Mee42/cube/motor_controller/motor_controller.kicad_pcb

## KiCad design motor_controller/motor_controller.kicad_pcb (2026-05-20)

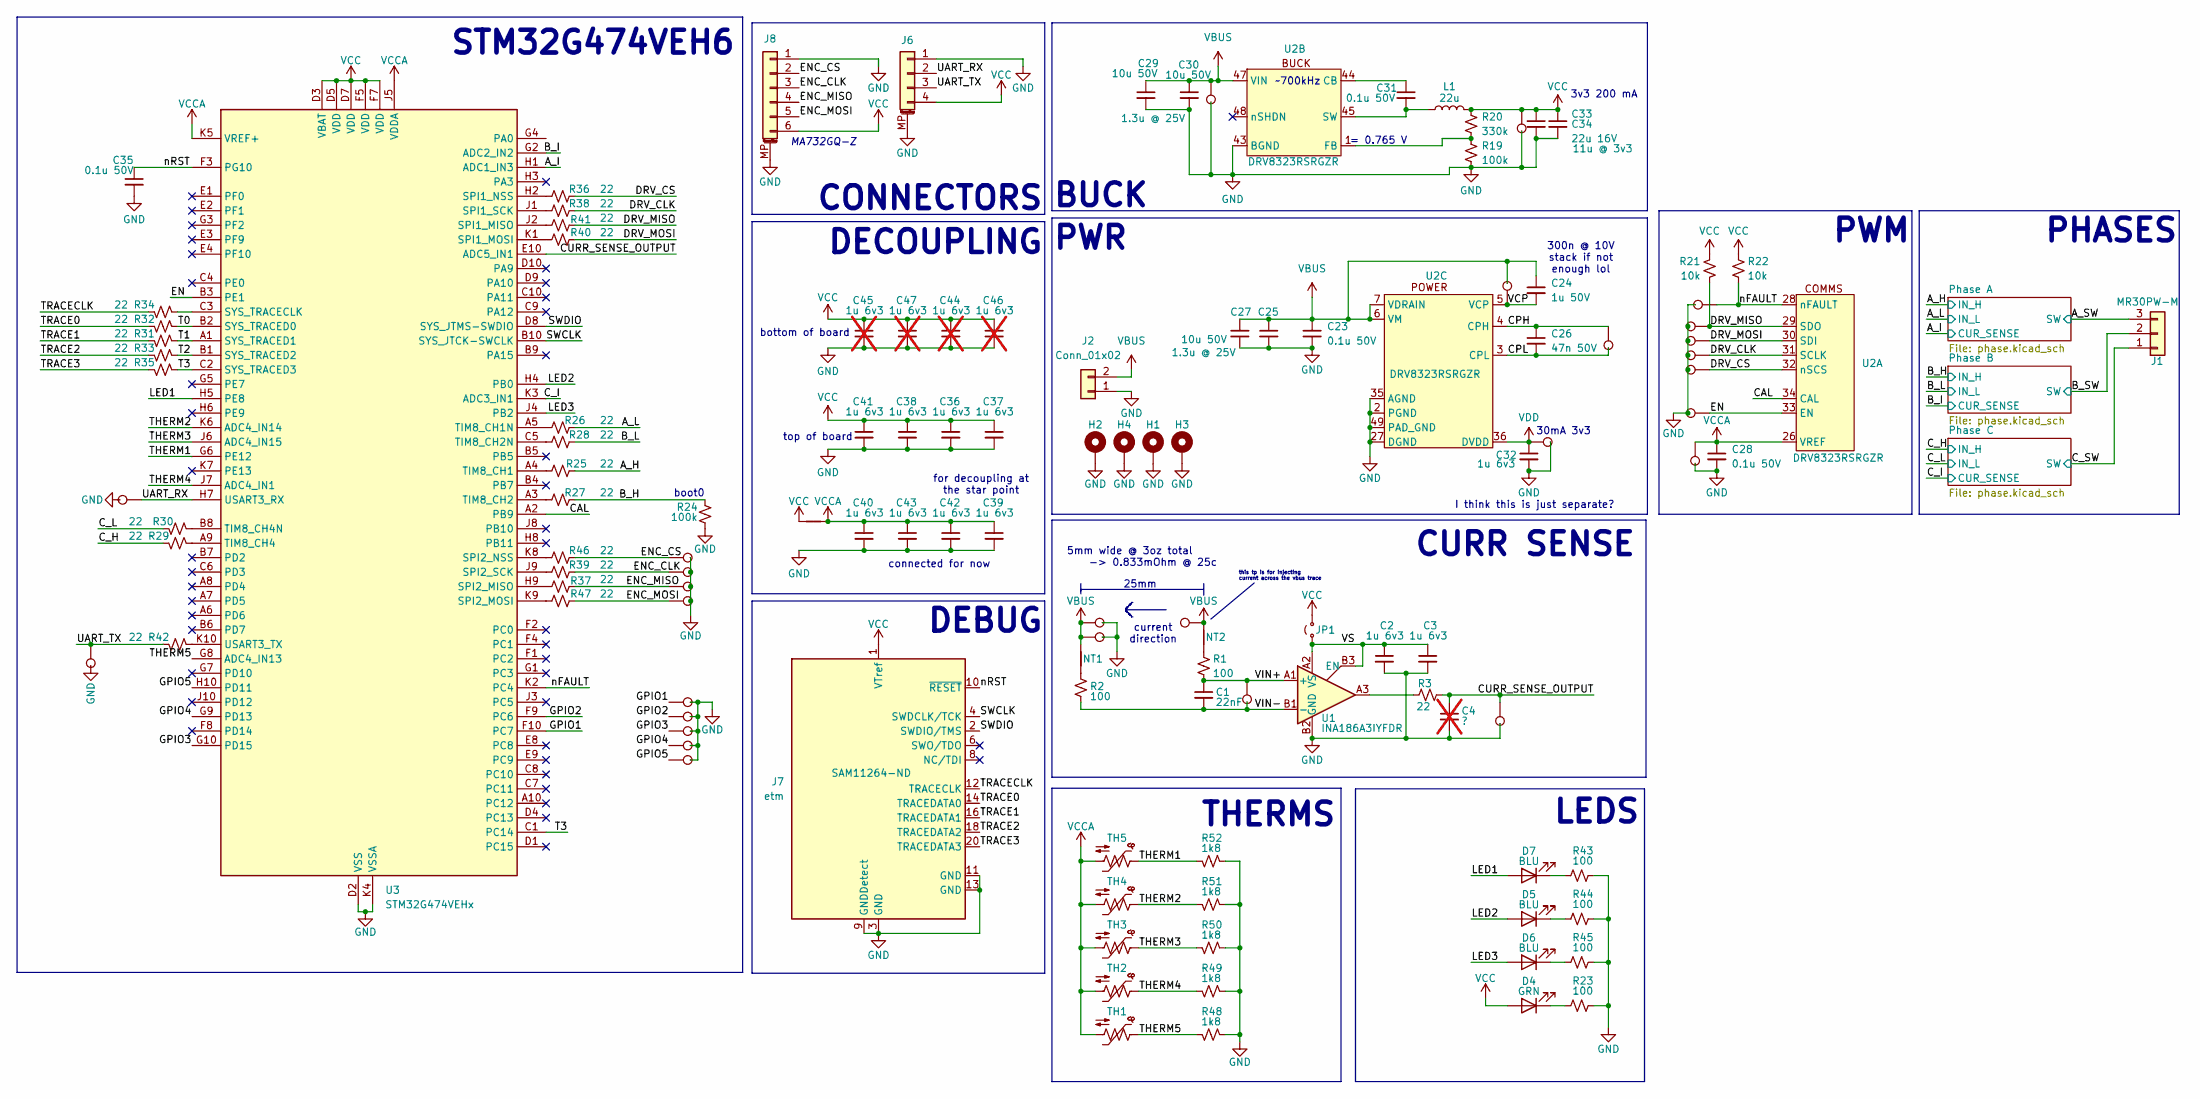
[picture p1: schematic motor_controller.kicad_sch]

Parts:
C1: 22nF; C_0402_1005Metric; MPN CC0402KRX7R9BB223
C2, C3, C32, C36, C37, C38, C39, C40, C41, C42, C43: 1u 6v3; C_0402_1005Metric; MPN CL05A105KQ5NNNC
C4: ?; C_0402_1005Metric; not fitted
C23, C28, C31, C35: 0.1u 50V; C_0402_1005Metric; MPN CL05B104KB54PNC
C24: 1u 50V; C_0603_1608Metric; MPN CL10A105KB8NNNC
C25, C27, C29, C30: 10u 50V; C_0805_2012Metric; MPN CL21A106KBYQNNE
C26: 47n 50V; C_0402_1005Metric; MPN CL05B473KB5VPNC
C33, C34: 22u 16V; C_0603_1608Metric; rating 11u @ 3v3; MPN CL10A226MO7JZNC
C44, C45, C46, C47: 1u 6v3; C_0402_1005Metric; MPN CL05B105KQ5NQNC; not fitted
D4: GRN; LED_0402_1005Metric; MPN XL-1005UGC
D5, D6, D7: BLU; LED_0402_1005Metric; MPN XL-1005UBC
H1, H2, H3, H4: MountingHole_Pad; MountingHole_2.2mm_M2_DIN965_Pad
J1: Conn_01x03; AMASS_MR30PW-M_1x03_P3.50mm_Horizontal; MPN MR30PW-M
J2: Conn_01x02; AMASS_XT30U-M_1x02_P5.0mm_Vertical
J6: uart; JST_ZE_SM04B-ZESS-TB_1x04-1MP_P1.50mm_Horizontal; MPN SM04B-ZESS-TB
J7: etm; SAMTEC_FTSH-110-01-F-DV-007; MPN FTSH-110-01-F-DV-007-K
J8: encoder; JST_ZE_SM06B-ZESS-TB_1x06-1MP_P1.50mm_Horizontal; MPN SM06B-ZESS-TB
JP1: Jumper_2_Bridged; SolderJumper-2_P1.3mm_Open_TrianglePad1.0x1.5mm
L1: 22u; L_0603_1608Metric; MPN CWF1610A-220K
NT1, NT2, NT3: NetTie_2; NetTie-2_SMD_Pad0.5mm
R1, R2, R23, R43, R44, R45: 100; R_0402_1005Metric; MPN FRC0402J101 TS
R3, R25, R26, R27, R28, R29, R30, R31, R32, R33, R34, R35, R36, R37, R38, R39, R40, R41, R42, R46, R47: 22; R_0402_1005Metric; MPN FRC0402J220 TS
R19, R24: 100k; R_0402_1005Metric; MPN FRC0402J104 TS
R20: 330k; R_0402_1005Metric; MPN FRC0402J334 TS
R21, R22: 10k; R_0402_1005Metric; MPN FRC0402J103 TS
R48, R49, R50, R51, R52: 1k8; R_0402_1005Metric; MPN FRC0402F1801TS
TH1, TH2, TH3, TH4, TH5: Thermistor_NTC_US; test point d1.5; MPN NRMR104F3435B2F
TP1, TP3, TP4, TP14, TP15, TP16, TP17, TP18, TP19, TP20, TP21, TP22, TP23, TP24, TP25, TP26, TP31, TP37, TP38, TP39, TP40, TP41, TP42, TP43, TP44, TP45, TP46: test point; test point d1.5
TP2: TestPoint; PinHeader_1x01_P2.54mm_Vertical
U1: INA186A3IYFDR; TSBGA_0.4mm_flipped; MPN INA186A3IYFDR
U2: VQFN-48-1EP_7x7mm_P0.5mm_EP4.1x4.1mm_ThermalVias; MPN DRV8323RSRGZR
U3: STM32G474VEHx; TFBGA-100_8x8mm_Layout10x10_P0.8mm; MPN STM32G474VEH6

Connections:
/A_H: R25.2; also elsewhere on the board
/A_I: U3.H1 (ADC1_IN3); also elsewhere on the board
/A_L: R26.2; also elsewhere on the board
/A_SW: J1.3; also elsewhere on the board
/B_H: R24.1, R27.2, U2.39 (INHB); also elsewhere on the board
/B_I: U2.24 (SOB), U3.G2 (ADC2_IN2); also elsewhere on the board
/B_L: R28.2, U2.40 (INLB); also elsewhere on the board
/B_SW: J1.2, U2.16 (SHB); also elsewhere on the board
/CAL: U2.34 (CAL), U3.A2 (PB9)
/CPH: C26.1, TP19.1, U2.4 (CPH)
/CPL: C26.2, TP19.2 (1), U2.3 (CPL)
/CURR_SENSE_OUTPUT: C4.1, R3.2, TP4.1, U3.E10 (ADC5_IN1)
/C_H: R29.2, U2.41 (INHC); also elsewhere on the board
/C_I: U2.23 (SOC), U3.K3 (ADC3_IN1); also elsewhere on the board
/C_L: R30.2, U2.42 (INLC); also elsewhere on the board
/C_SW: J1.1, U2.19 (SHC); also elsewhere on the board
/DRV_CLK: R38.2, TP18.1, U2.31 (SCLK)
/DRV_CS: R36.2, TP15.1, U2.32 (nSCS)
/DRV_MISO: R21.1, R41.2, TP21.1, U2.29 (SDO)
/DRV_MOSI: R40.2, TP20.1, U2.30 (SDI)
/EN: TP14.1, U2.33 (EN), U3.B3 (PE1)
/ENC_CLK: J8.3, R39.2, TP42.1
/ENC_CS: J8.2, R46.2, TP44.1
/ENC_MISO: J8.4, R37.2, TP40.1
/ENC_MOSI: J8.5, R47.2, TP38.1
/GPIO1: TP37.1, U3.F10 (PC7)
/GPIO2: TP39.1, U3.F9 (PC6)
/GPIO3: TP41.1, U3.G10 (PD15)
/GPIO4: TP43.1, U3.G9 (PD13)
/GPIO5: TP45.1, U3.H10 (PD11)
/LED1: D7.2 (A), U3.H5 (PE8)
/LED2: D5.2 (A), U3.H4 (PB0)
/LED3: D6.2 (A), U3.J4 (PB2)
/SWCLK: J7.4 (SWDCLK/TCK), U3.B10 (SYS_JTCK-SWCLK)
/SWDIO: J7.2 (SWDIO/TMS), U3.D8 (SYS_JTMS-SWDIO)
/T0: R32.1, U3.B2 (SYS_TRACED0)
/T1: R31.1, U3.A1 (SYS_TRACED1)
/T2: R33.1, U3.B1 (SYS_TRACED2)
/T3: R35.1, U3.C1 (PC14), U3.C2 (SYS_TRACED3)
/THERM1: R52.1, TH5.1, U3.G6 (PE12)
/THERM2: R51.1, TH4.1, U3.K6 (ADC4_IN14)
/THERM3: R50.1, TH3.1, U3.J6 (ADC4_IN15)
/THERM4: R49.1, TH2.1, U3.J7 (ADC4_IN1)
/THERM5: R48.1, TH1.1, U3.G8 (ADC4_IN13)
/TRACE0: J7.14 (TRACEDATA0), R32.2
/TRACE1: J7.16 (TRACEDATA1), R31.2
/TRACE2: J7.18 (TRACEDATA2), R33.2
/TRACE3: J7.20 (TRACEDATA3), R35.2
/TRACECLK: J7.12 (TRACECLK), R34.2
/UART_RX: J6.2, TP31.1, U3.H7 (USART3_RX)
/UART_TX: J6.3, R42.2, TP25.1
/VCP: C24.2, TP16.1, U2.5 (VCP)
/VIN+: C1.1, R1.2, TP3.1, U1.A1 (+)
/VIN-: C1.2, R2.2, TP3.2 (1), U1.B1 (-)
/VS: C2.1, C3.1, JP1.1 (A), U1.A2 (VS), U1.B3 (EN)
/nFAULT: R22.1, TP23.1, U2.28 (nFAULT), U3.K2 (PC4)
/nRST: C35.1, J7.10 (~RESET), U3.F3 (PG10)
GND: C2.2, C3.2, C4.2, C23.2, C25.2, C27.2, C28.2, C29.2, C30.2, C32.2, C33.2, C34.2, C35.2, C36.2, C37.2, C38.2, C39.2, C40.2, C41.2, C42.2, C43.2, C44.2, C45.2, C46.2, C47.2, H1.1 (1_1), H2.1 (1_1), H3.1 (1_1), H4.1 (1_1), J2.1, J6.1, J6.MP (MountPin), J7.3 (GND), J7.5 (GND), J7.9 (GNDDetect), J7.11 (GND), J7.13 (GND), J7.15 (GND), J7.17 (GND), J7.19 (GND), J8.1, J8.MP (MountPin), R19.2, R23.2, R24.2, R43.2, R44.2, R45.2, R48.2, R49.2, R50.2, R51.2, R52.2, TP1.2 (1), TP4.2 (1), TP14.2 (1), TP15.2 (1), TP17.2 (1), TP18.2 (1), TP20.2 (1), TP21.2 (1), TP22.2 (1), TP23.2 (1), TP24.2 (1), TP25.2 (1), TP26.2 (1), TP31.2 (1), TP37.2 (1), TP38.2 (1), TP39.2 (1), TP40.2 (1), TP41.2 (1), TP42.2 (1), TP43.2 (1), TP44.2 (1), TP45.2 (1), TP46.2 (1), U1.B2 (GND), U2.2 (PGND), U2.27 (DGND), U2.35 (AGND), U2.43 (BGND), U2.49 (PAD_GND), U3.D2 (VSS), U3.D6 (VSS), U3.E5 (VSS), U3.E6 (VSS), U3.E7 (VSS), U3.F6 (VSS), U3.K4 (VSSA); also elsewhere on the board
unnamed: D4.1 (K), R23.1
unnamed: D5.1 (K), R44.1
unnamed: D6.1 (K), R45.1
unnamed: D7.1 (K), R43.1
unnamed: NT1.1, R2.1
unnamed: NT2.1, R1.1
unnamed: R3.1, U1.A3
unnamed: C31.1, U2.44 (CB)
unnamed: R19.1, R20.2, U2.1 (FB)
unnamed: C31.2, L1.1, U2.45 (SW)
unnamed 87: U2.17 (GHB); also elsewhere on the board
unnamed 88: U2.15 (GLB); also elsewhere on the board
unnamed 89: U2.13 (SNB); also elsewhere on the board
unnamed 90: U2.14 (SPB); also elsewhere on the board
unnamed 91: U2.18 (GHC); also elsewhere on the board
unnamed 92: U2.20 (GLC); also elsewhere on the board
unnamed 93: U2.22 (SNC); also elsewhere on the board
unnamed 94: U2.21 (SPC); also elsewhere on the board
unnamed: R36.1, U3.H2 (SPI1_NSS)
unnamed: R38.1, U3.J1 (SPI1_SCK)
unnamed: R41.1, U3.J2 (SPI1_MISO)
unnamed: R40.1, U3.K1 (SPI1_MOSI)
unnamed: R26.1, U3.A5 (TIM8_CH1N)
unnamed: R28.1, U3.C5 (TIM8_CH2N)
unnamed: R25.1, U3.A4 (TIM8_CH1)
unnamed: R27.1, U3.A3 (TIM8_CH2)
unnamed: R46.1, U3.K8 (SPI2_NSS)
unnamed: R39.1, U3.J9 (SPI2_SCK)
unnamed: R37.1, U3.H9 (SPI2_MISO)
unnamed: R47.1, U3.K9 (SPI2_MOSI)
unnamed: R30.1, U3.B8 (TIM8_CH4N)
unnamed: R29.1, U3.A9 (TIM8_CH4)
unnamed: R42.1, U3.K10 (USART3_TX)
unnamed: R34.1, U3.C3 (SYS_TRACECLK)
VBUS: C23.1, C24.1, C25.1, C27.1, C29.1, C30.1, J2.2, NT1.2, NT2.2, TP1.1, TP2.1 (1_1), TP16.2 (1), TP17.1, TP46.1, U2.6 (VM), U2.7 (VDRAIN), U2.47 (VIN); also elsewhere on the board
VCC: C33.1, C34.1, C36.1, C37.1, C38.1, C41.1, C44.1, C45.1, C46.1, C47.1, D4.2 (A), J6.4, J7.1 (VTref), J8.6, JP1.2 (B), L1.2, NT3.2, R20.1, R21.2, R22.2, TP22.1, U3.D3 (VBAT), U3.D5 (VDD), U3.D7 (VDD), U3.F5 (VDD), U3.F7 (VDD)
VCCA: C28.1, C39.1, C40.1, C42.1, C43.1, NT3.1, TH1.2, TH2.2, TH3.2, TH4.2, TH5.2, TP24.1, U2.26 (VREF), U3.J5 (VDDA), U3.K5 (VREF+)
VDD: C32.1, TP26.1, U2.36 (DVDD)

Notes on the sheet:
30mA 3v3
connected for now
25mm
LEDS
PWM
300n @ 10V stack if not enough lol
~700kHz
this tp is for injecting current across the vbus trace
BUCK
PHASES
current direction
I think this is just separate?
CURR SENSE
STM32G474VEH6
PWR
3v3 200 mA
5mm wide @ 3oz total -> 0.833mOhm @ 25c
top of board
boot0
MA732GQ-Z
bottom of board
DEBUG
CONNECTORS
DECOUPLING
for decoupling at the star point
THERMS
= 0.765 V

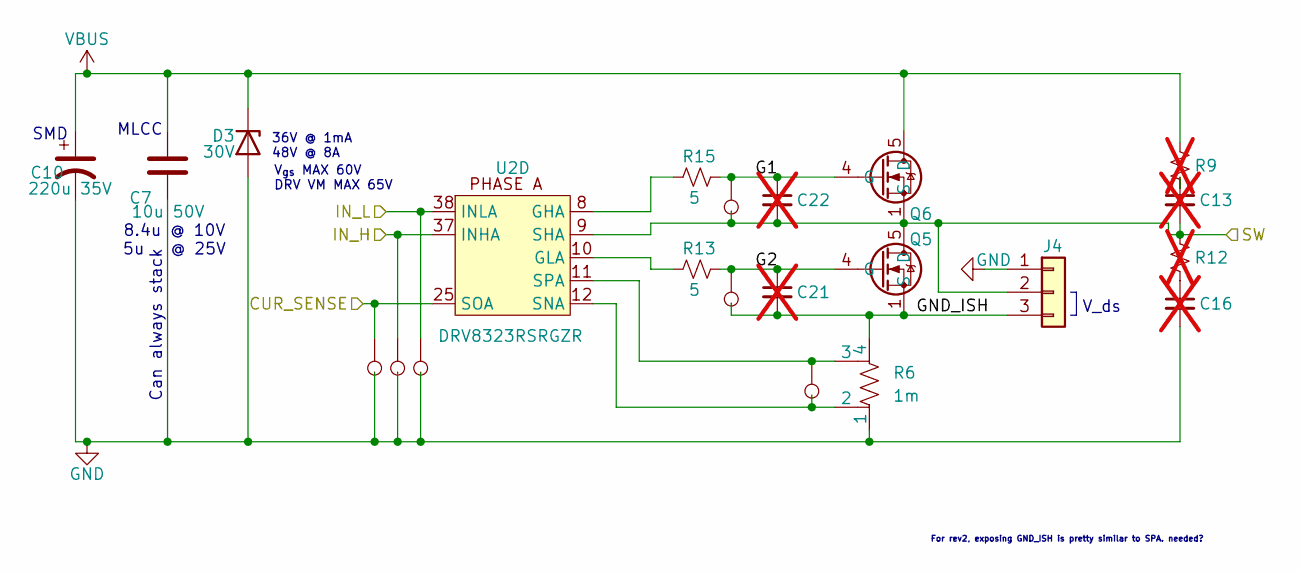
[picture p2: schematic phase.kicad_sch]

Parts:
C7: 10u 50V; C_1210_3225Metric; MPN CL32Y106KBJVPJE
C10: 220u 35V; CP_Elec_6.3x7.7_mine; MPN RV35V220M6X8
C13, C16, C21, C22: C_Small; C_0402_1005Metric; not fitted
D3: 30V; D_SMA; MPN SMAJ30A
J4: Conn_01x03; tp_3x
Q5, Q6: Infineon_PG-TDSON-8_6.15x5.15mm; MPN BSC110N06NS3GATMA1
R6: 1m; R_0805_SHUNT; MPN PA0805FRL870R001L
R9, R12: R_Small_US; R_0402_1005Metric; not fitted
R13, R15: 5; R_0402_1005Metric; MPN FRC0402J3R3 TS
TP7, TP10, TP11, TP27, TP33, TP36: test point; test point d1.5
U2: VQFN-48-1EP_7x7mm_P0.5mm_EP4.1x4.1mm_ThermalVias; MPN DRV8323RSRGZR

Connections:
/A_H: TP33.1, U2.37 (INHA); also elsewhere on the board
/A_I: TP36.1, U2.25 (SOA); also elsewhere on the board
/A_L: TP27.1, U2.38 (INLA); also elsewhere on the board
/A_SW: C13.2, C22.2, J4.2, Q5.5 (D), Q6.1 (S), Q6.2 (S), Q6.3 (S), R12.1, TP11.2 (1), U2.9 (SHA); also elsewhere on the board
/B_H: U2.39 (INHB); also elsewhere on the board
/B_I: U2.24 (SOB); also elsewhere on the board
/B_L: U2.40 (INLB); also elsewhere on the board
/B_SW: U2.16 (SHB); also elsewhere on the board
/C_H: U2.41 (INHC); also elsewhere on the board
/C_I: U2.23 (SOC); also elsewhere on the board
/C_L: U2.42 (INLC); also elsewhere on the board
/C_SW: U2.19 (SHC); also elsewhere on the board
/Phase A/G1: C22.1, Q6.4 (G), R15.2, TP11.1
/Phase A/G2: C21.1, Q5.4 (G), R13.2, TP10.1
/Phase A/GND_ISH: C21.2, J4.3, Q5.1 (S), Q5.2 (S), Q5.3 (S), R6.4, TP10.2 (1)
GND: C7.2, C10.2, C16.2, D3.2 (A), J4.1, R6.1, TP27.2 (1), TP33.2 (1), TP36.2 (1); also elsewhere on the board
unnamed: C13.1, R9.2
unnamed: C16.1, R12.2
unnamed: R15.1, U2.8 (GHA)
unnamed: R13.1, U2.10 (GLA)
unnamed: R6.2, TP7.2 (1), U2.12 (SNA)
unnamed: R6.3, TP7.1, U2.11 (SPA)
unnamed 87: U2.17 (GHB); also elsewhere on the board
unnamed 88: U2.15 (GLB); also elsewhere on the board
unnamed 89: U2.13 (SNB); also elsewhere on the board
unnamed 90: U2.14 (SPB); also elsewhere on the board
unnamed 91: U2.18 (GHC); also elsewhere on the board
unnamed 92: U2.20 (GLC); also elsewhere on the board
unnamed 93: U2.22 (SNC); also elsewhere on the board
unnamed 94: U2.21 (SPC); also elsewhere on the board
VBUS: C7.1, C10.1, D3.1 (K), Q6.5 (D), R9.1; also elsewhere on the board

Parts of its further copies:
C5, C6: 10u 50V; C_1210_3225Metric; MPN CL32Y106KBJVPJE
C8, C9: 220u 35V; CP_Elec_6.3x7.7_mine; MPN RV35V220M6X8
C11, C12, C14, C15, C17, C18, C19, C20: C_Small; C_0402_1005Metric; not fitted
D1, D2: 30V; D_SMA; MPN SMAJ30A
J3, J5: Conn_01x03; tp_3x
R4, R5: 1m; R_0805_SHUNT; MPN PA0805FRL870R001L
R7, R8, R10, R11: R_Small_US; R_0402_1005Metric; not fitted
R14, R16, R17, R18: 5; R_0402_1005Metric; MPN FRC0402J3R3 TS
TP5, TP6, TP8, TP9, TP12, TP13, TP28, TP29, TP30, TP32, TP34, TP35: test point; test point d1.5

Connections of its further copies:
/B_H: TP34.1; also elsewhere on the board
/B_I: TP32.1; also elsewhere on the board
/B_L: TP28.1; also elsewhere on the board
/B_SW: C12.2, C19.2, J3.2, R11.1, TP8.2 (1); also elsewhere on the board
/C_H: TP35.1; also elsewhere on the board
/C_I: TP30.1; also elsewhere on the board
/C_L: TP29.1; also elsewhere on the board
/C_SW: C11.2, C18.2, J5.2, R10.1, TP13.2 (1); also elsewhere on the board
/Phase B/G1: C19.1, R16.2, TP8.1; also elsewhere on the board
/Phase B/G2: C20.1, R14.2, TP9.1; also elsewhere on the board
/Phase B/GND_ISH: C20.2, J3.3, R5.4, TP9.2 (1); also elsewhere on the board
/Phase C/G1: C18.1, R17.2, TP13.1; also elsewhere on the board
/Phase C/G2: C17.1, R18.2, TP12.1; also elsewhere on the board
/Phase C/GND_ISH: C17.2, J5.3, R4.4, TP12.2 (1); also elsewhere on the board
GND: C5.2, C6.2, C8.2, C9.2, C14.2, C15.2, D1.2 (A), D2.2 (A), J3.1, J5.1, R4.1, R5.1, TP28.2 (1), TP29.2 (1), TP30.2 (1), TP32.2 (1), TP34.2 (1), TP35.2 (1); also elsewhere on the board
unnamed: C11.1, R7.2
unnamed: C12.1, R8.2
unnamed: C14.1, R10.2
unnamed: C15.1, R11.2
unnamed 87: R16.1; also elsewhere on the board
unnamed 88: R14.1; also elsewhere on the board
unnamed 89: R5.2, TP6.2 (1); also elsewhere on the board
unnamed 90: R5.3, TP6.1; also elsewhere on the board
unnamed 91: R17.1; also elsewhere on the board
unnamed 92: R18.1; also elsewhere on the board
unnamed 93: R4.2, TP5.2 (1); also elsewhere on the board
unnamed 94: R4.3, TP5.1; also elsewhere on the board
VBUS: C5.1, C6.1, C8.1, C9.1, D1.1 (K), D2.1 (K), R7.1, R8.1; also elsewhere on the board

Notes on the sheet:
SMD
36V @ 1mA 48V @ 8A
V_{gs} MAX 60V DRV VM MAX 65V
Can always stack
MLCC
For rev2, exposing GND_ISH is pretty similar to SPA. needed?
8.4u @ 10V 5u @ 25V
V_ds

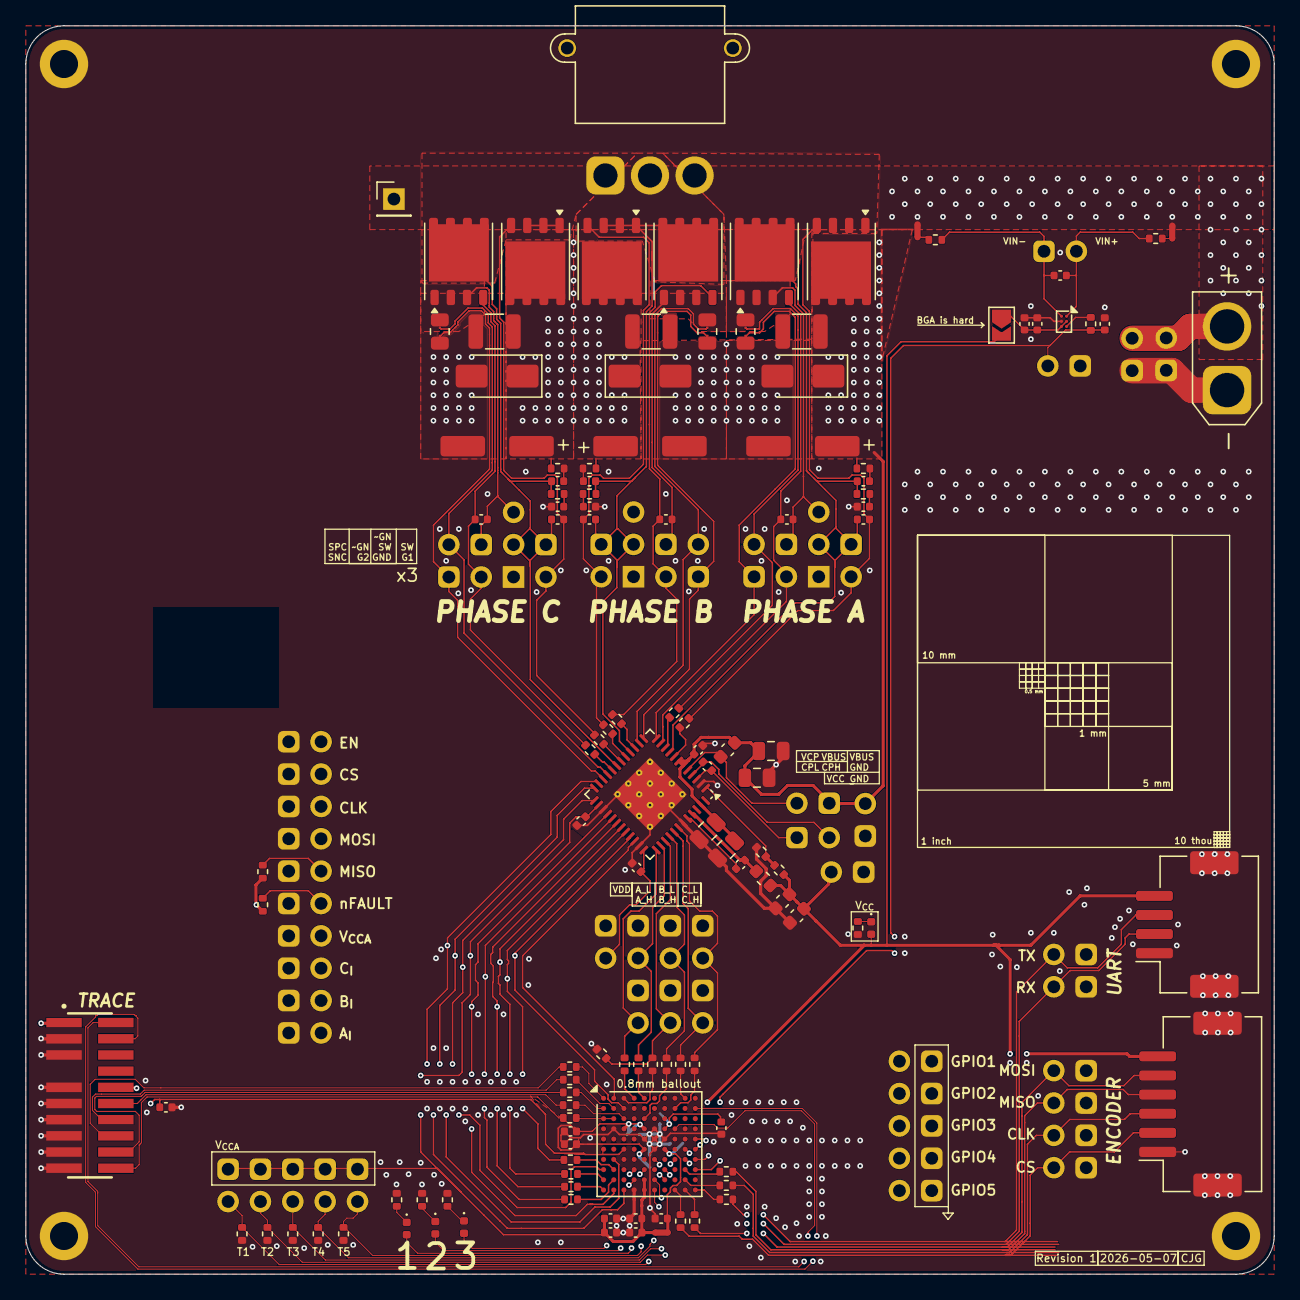
[picture p3: board motor_controller.kicad_pcb from above]

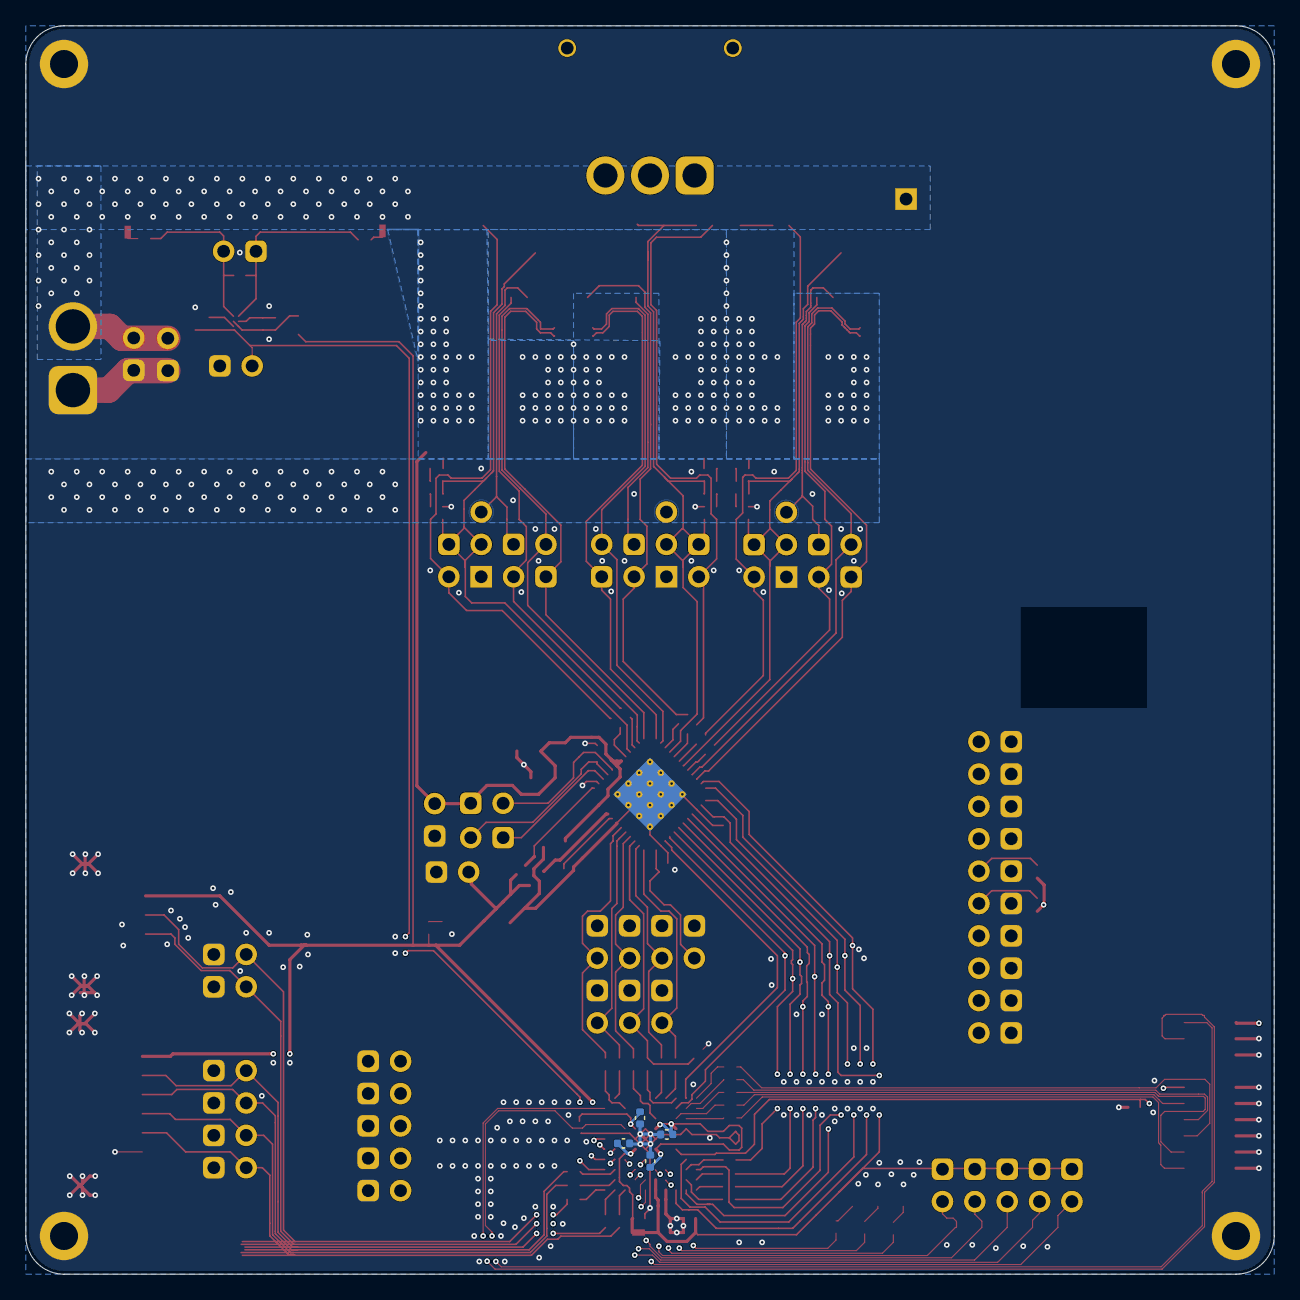
[picture p4: board motor_controller.kicad_pcb from below]

Board: 4 copper layers, 98.0 x 98.0 mm, 183 parts (4 on the bottom side), 115 nets.

Other parts of the board:
Q1, Q2, Q3, Q4: Infineon_PG-TDSON-8_6.15x5.15mm

Their connections:
/B_SW: Q3.1 (S), Q3.2 (S), Q3.3 (S), Q4.5 (D); also elsewhere on the board
/C_SW: Q1.5 (D), Q2.1 (S), Q2.2 (S), Q2.3 (S); also elsewhere on the board
/Phase B/G1: Q3.4 (G); also elsewhere on the board
/Phase B/G2: Q4.4 (G); also elsewhere on the board
/Phase B/GND_ISH: Q4.1 (S), Q4.2 (S), Q4.3 (S); also elsewhere on the board
/Phase C/G1: Q2.4 (G); also elsewhere on the board
/Phase C/G2: Q1.4 (G); also elsewhere on the board
/Phase C/GND_ISH: Q1.1 (S), Q1.2 (S), Q1.3 (S); also elsewhere on the board
VBUS: Q2.5 (D), Q3.5 (D); also elsewhere on the board
