Mee42/cube/cube.ioc

Mcu.UserName=STM32G474VEHx
PA1.Signal=ADC2_IN2
PA13.Signal=SYS_JTMS-SWDIO
PA14.Signal=SYS_JTCK-SWCLK
PA2.Signal=ADC1_IN3
PA8.Signal=ADC5_IN1
PB0.Signal=GPIO_Output
PB1.Signal=ADC3_IN1
PB12.Signal=SPI2_NSS
PB13.Signal=SPI2_SCK
PB14.Signal=SPI2_MISO
PB15.Signal=SPI2_MOSI
PB3.Signal=TIM8_CH1N
PB4.Signal=TIM8_CH2N
PB6.Signal=S_TIM8_CH1
PB8-BOOT0.Signal=S_TIM8_CH2
PC6.Signal=GPIO_Output
PC7.Signal=GPIO_Output
PD0.Signal=TIM8_CH4N
PD1.Signal=S_TIM8_CH4
PD11.Signal=GPIO_Output
PD13.Signal=GPIO_Output
PD15.Signal=GPIO_Output
PD9.Signal=ADC4_IN13
PE10.Signal=ADC4_IN14
PE11.Signal=ADC4_IN15
PE12.Signal=ADC4_IN16
PE14.Signal=ADC4_IN1
PE2.Signal=SYS_TRACECLK
PE3.Signal=SYS_TRACED0
PE4.Signal=SYS_TRACED1
PE5.Signal=SYS_TRACED2
PE6.Signal=SYS_TRACED3
PE8.Signal=GPIO_Output
