Mee42/cube/(commit log)

2025-08-02 inital commit
    [motor_controller.kicad_pcb, motor_controller.kicad_sch, phase.kicad_sch]
2025-08-02 BALLed out
    [motor_controller.kicad_pcb, motor_controller.kicad_sch, phase.kicad_sch]
2025-08-02 trying replicate..
    [motor_controller.kicad_pcb]
2025-08-02 added credit card lol
    [motor_controller.kicad_pcb]
2025-08-02 layout mostly done
    [motor_controller.kicad_pcb, motor_controller.kicad_sch]
2025-08-02 passes drc lol
    [motor_controller.kicad_pcb]
2025-11-01 still gotta put temp sensors on lol
    [motor_controller.kicad_pcb, motor_controller.kicad_sch, phase.kicad_sch]
2025-11-01 didn't save schematic
    [motor_controller.kicad_sch]
2026-05-08 getting back into it?
    [motor_controller.kicad_pcb, motor_controller.kicad_sch, phase.kicad_sch, probes.kicad_pcb, probes.kicad_sch]
2026-05-08 pre geographical annotation
    [motor_controller.kicad_pcb]
2026-05-08 geographical reannotate
    [motor_controller.kicad_pcb, motor_controller.kicad_sch, phase.kicad_sch]
2026-05-08 orderable, at all?
    [motor_controller.kicad_pcb, motor_controller.kicad_sch, phase.kicad_sch]
2026-05-08 i should just fucking order it
    [motor_controller.kicad_pcb, motor_controller.kicad_sch]
